ikoc/EkoPedal/images/onOffSwitch.jpeg

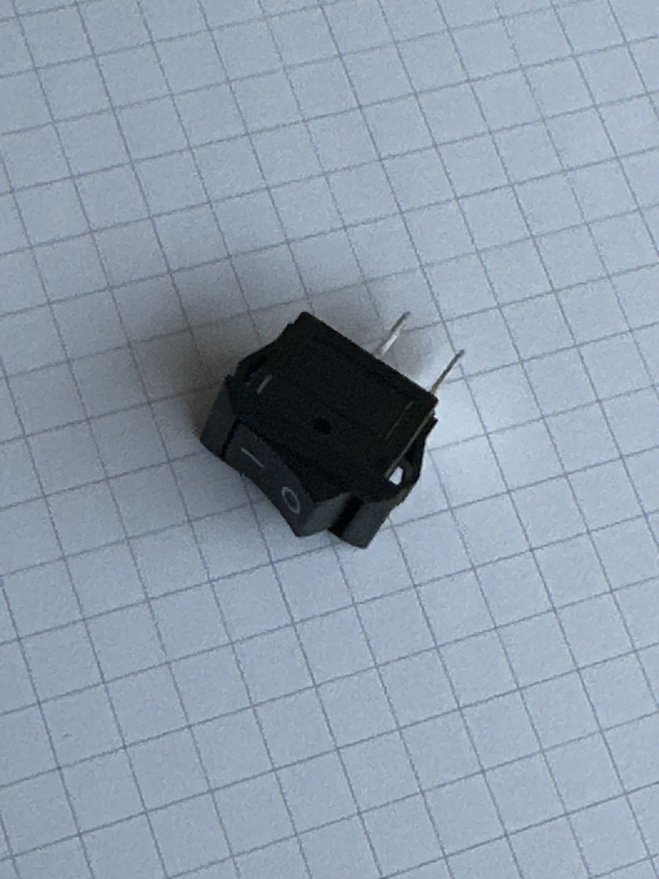
images/onOffSwitch.jpeg
