ikoc/EkoPedal/images/buttonImg.jpeg

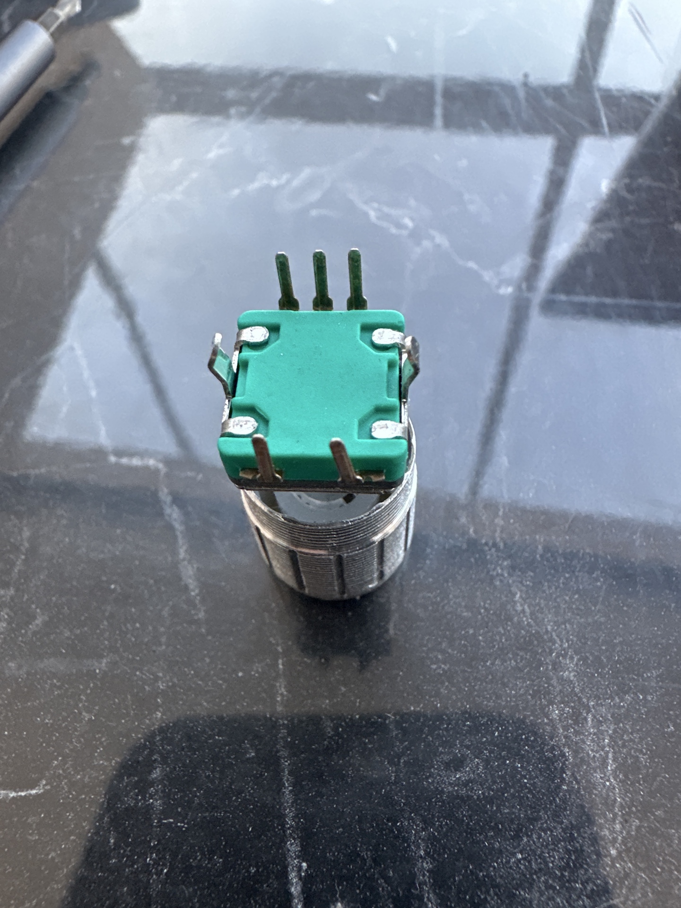
images/buttonImg.jpeg
