ikoc/EkoPedal/profiles/README.md

# Profiles

Aşama 2'de JSON makro profilleri burada tutulacak.
