ikoc/EkoPedal/cad/cikti/B_arka.png

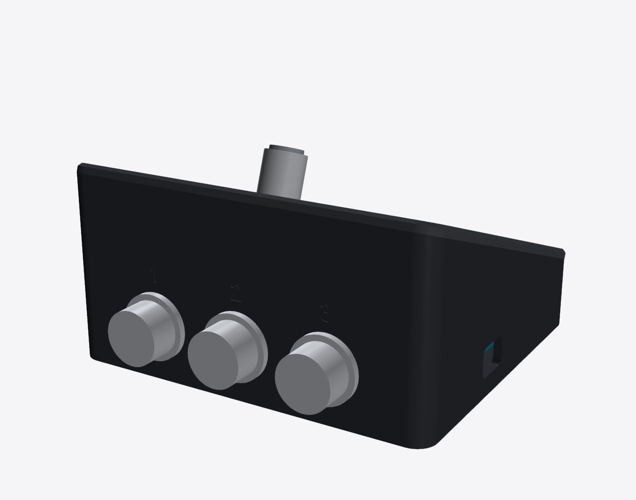
cad/cikti/B_arka.png
