ikoc/EkoPedal/cad/cikti/B_enkoder_tutucu.png

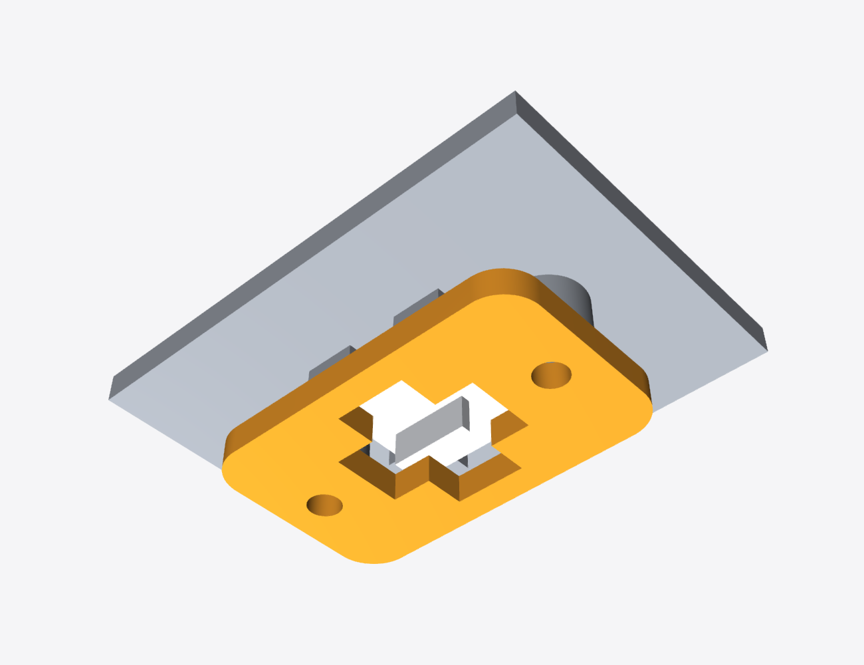
cad/cikti/B_enkoder_tutucu.png
