ikoc/EkoPedal/cad/cikti/B_on.png

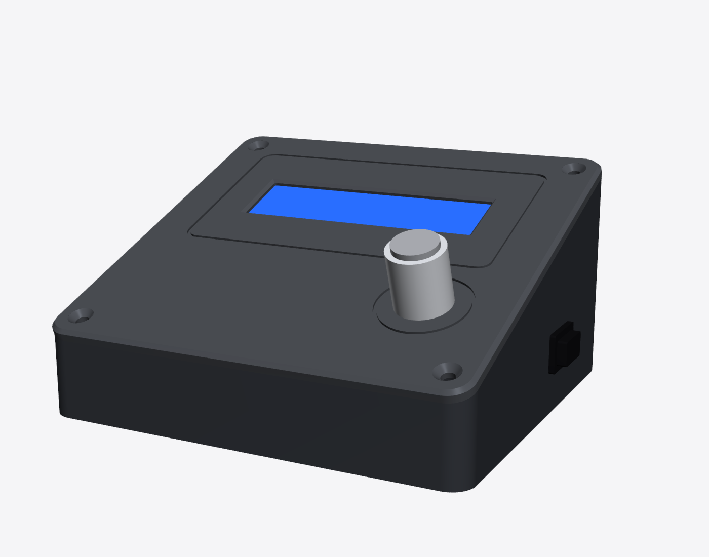
cad/cikti/B_on.png
