ikoc/EkoPedal/cad/cikti/B_panel_alt.png

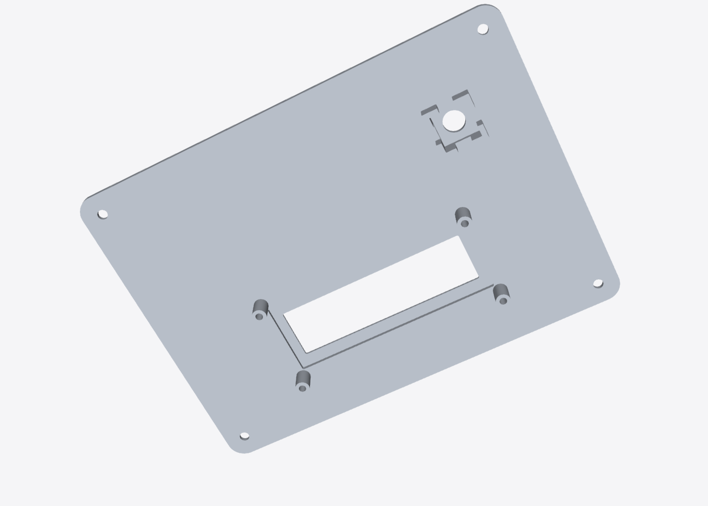
cad/cikti/B_panel_alt.png
