ikoc/EkoPedal/images/Image.jpeg

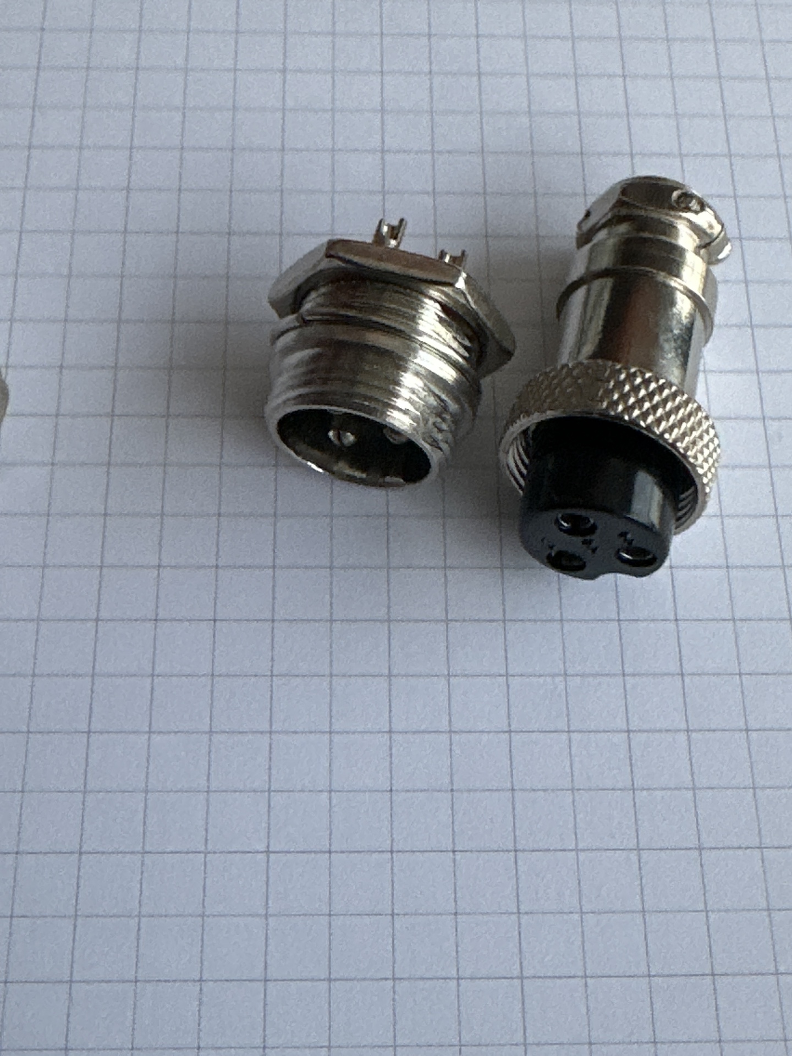
images/Image.jpeg
