ikoc/EkoPedal/images/referansImg.webp

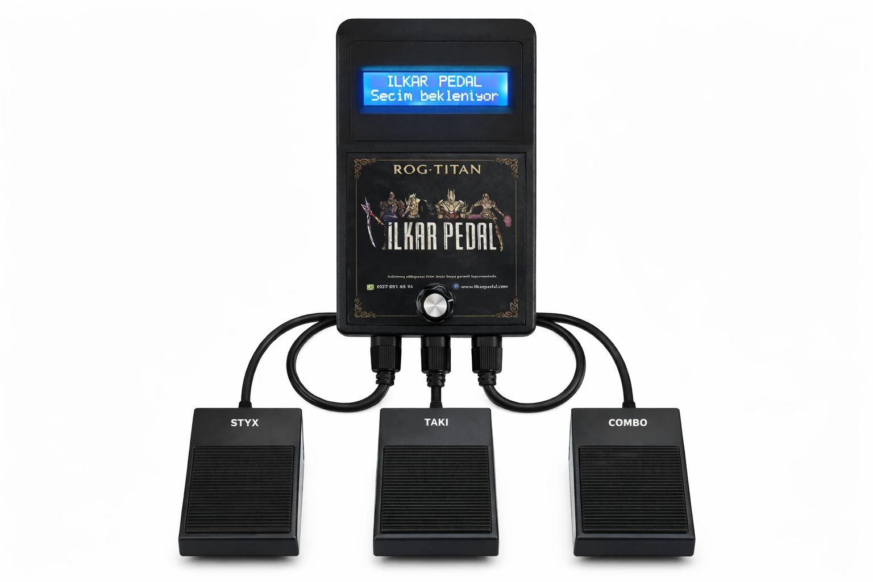
images/referansImg.webp
