ikoc/EkoPedal/cad/baski/B_kama/B_govde.stl

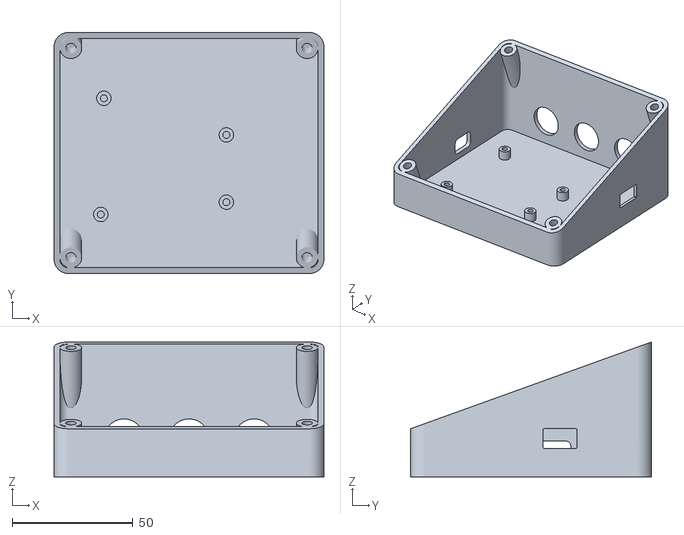
[picture p10: CAD file, 2026-10-25]
cad/baski/B_kama/B_govde.stl
112.0 x 100.0 x 56.0
