ikoc/EkoPedal/cad/baski/B_kama/B_test_kuponu.stl

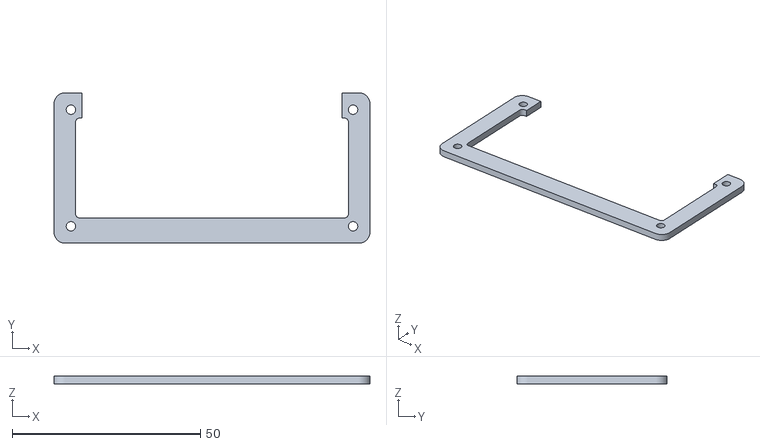
[picture p11: CAD file, 2026-10-25]
cad/baski/B_kama/B_test_kuponu.stl
84.0 x 40.0 x 2.00
