ikoc/EkoPedal/cad/baski/B_kama/B_panel.stl

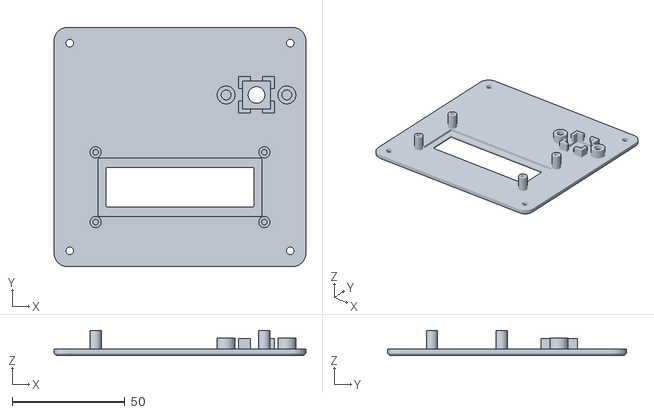
[picture p12: CAD file, 2026-10-25]
cad/baski/B_kama/B_panel.stl
112.0 x 106.3 x 11.2
