ikoc/EkoPedal/cad/baski/B_kama/B_enkoder_tutucu.stl

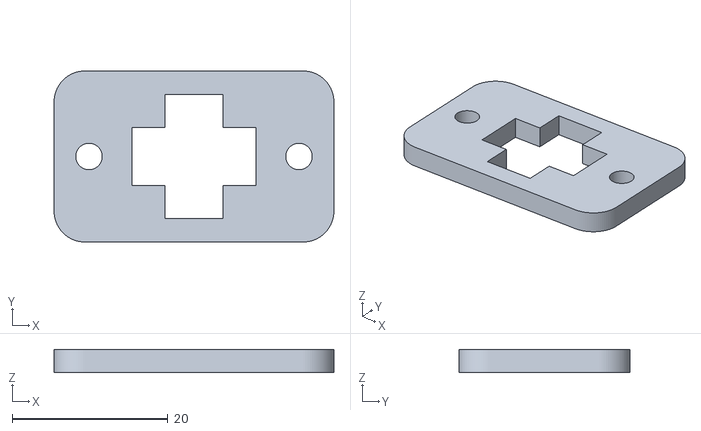
[picture p13: CAD file, 2026-10-24]
cad/baski/B_kama/B_enkoder_tutucu.stl
36.0 x 22.0 x 3.00
