ikoc/EkoPedal/cad/cikti/B_test_kuponu.png

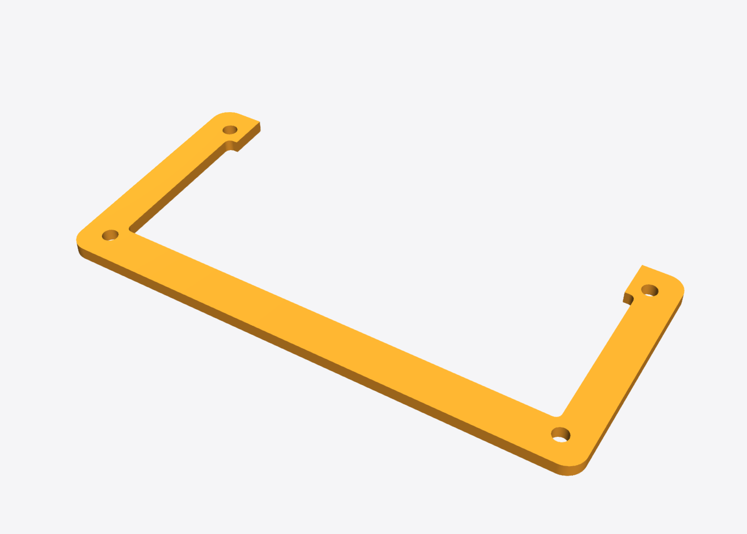
cad/cikti/B_test_kuponu.png
