ikoc/EkoPedal/(commit log)

2026-10-24 Kutu tasarımları (CAD, STL), LCD kodu ve bileşen fotoğrafları eklendi
    - cad/: CadQuery ile 3 kontrol kutusu tasarımı (A Kule, B Kama, C Yatay), Bambu Lab X2D için
    baskı yönünde STL'ler. Seçilen B Kama: 112 x 100 x 59 mm, ölçülmüş bileşenlere göre
    (LCD 74x30 delik, EC11 düz mil + tutucu, mini rocker 13x8, GX16, Leonardo), 6 x M3x4x5 insert (Ø4.4).
    - cad/baski/B_kama/B_test_kuponu.stl: LCD, enkoder+tutucu, insert, anahtar, GX16 geçme testi.
    - cad/cikti/EkoPedal_3B.html: patlatma/kesit/yarı saydam 3B görüntüleyici; renderlar.
    - arduino lcd led/: HW-61 I2C LCD kütüphanesi (LcdEkran), enkoder ve I2C tarayıcı testleri.
    - images/: referans ve bileşen fotoğraflar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
    [A_govde.stl, A_kapak.stl, B_enkoder_tutucu.stl, B_govde.stl, B_panel.stl, B_test_kuponu.stl, B_yazi_inlay.stl, C_egim_ayagi_1.stl]
2026-10-25 B Kama: kupon sonuçları işlendi, A/C ve panel yazısı kaldırıldı
    Test kuponu sonuçları (24-25 Eki):
    - Insert Ø4.4, GX16, enkoder + tutucu: onaylandı.
    - Anahtar deliği 13.2 dar geldi -> 14.0 x 8.3 (onaylandı).
    - LCD vida delikleri 74 x 30 olmadı -> 75 x 31 (onaylandı); kuleler 8.2 mm.
    - Panel altı tutucu insert deliği 5.0 derin (ön yüz kabarmasın), tutucu vidası M3x6.
    Baskı düzeltmesi:
    - Ön yüz tablada basılan panelde 88x48 LCD girintisi tabanı havada kalıyordu
    (kupon 2'de LCD bölümü tablaya tutmadı) -> 0.8 mm ince çerçeve oluğu.
    Temizlik:
    - A (Kule) ve C (Yatay) tasarımları silindi; sadece B Kama kaldı.
    - "eKO PEDAL" yazı oyuğu ve yazı parçası k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
    [A_govde.stl, A_kapak.stl, B_govde.stl, B_panel.stl, B_test_kuponu.stl, B_yazi_inlay.stl, C_egim_ayagi_1.stl, C_egim_ayagi_2.stl]
2026-10-25 Windows geliştirmesi (EkoPedal_Windows_Dev_2026-10-25.zip)
    Windows bilgisayardaki son dosya hali; o taraftaki git geçmişi (63a6d0f, 6548a97 vb.)
    zip'te olmadığı için tek commit olarak alındı.
    - firmware/leonardo_menu: iç içe menü, eKO PEDAL açılışı, encoder D6/D9 + basma D7,
    5 ms HID zamanlaması, ayar sürümü 9.
    - firmware/lcd_i2c_test: bağımsız HW-61 LCD testi.
    - docs/PROJECT_STATE.md: güncel durum, pin haritası, Windows devam adımları.
    - docs/lcd_menu.md, README.md: PROJECT_STATE'e yönlendirme, encoder pinleri.
2026-10-25 Baskıda doğrulanan montaj ölçüleri kaydedildi, Leonardo ayakları M3'e göre
    - cad/README.md: "Doğrulanmış montaj ölçüleri" tablosu (LCD 75x31 / 8.2 kule, EC11 enkoder cebi +
    tutucu, insert Ø4.4, anahtar 14.0x8.3, GX16 Ø16.2, Leonardo delik konumları) – 25 Eki baskısı.
    - Leonardo ayakları: pilot Ø2.6 -> Ø2.9, derinlik 4.4 -> 6.6 mm (M3 kendi dişini açar, LCD ile aynı yöntem).
    - ortak.py: doğrulanmış ölçüler notu ve LEO_* parametreleri.
    [B_govde.stl]
2026-10-25 Doğrulanmış pin haritası, bağlantı test uygulaması, A0 açma/kapama anahtarı
    - docs/PIN_HARITASI.md: tüm Leonardo pinleri, ortak GND hattı (7 uç), EC11 enkoder bacak dizilimi,
    GX16 konnektör düzeni, pedal ve anahtar davranışı, LCD notları. 25 Eki'de tüm parçalar bağlıyken doğrulandı.
    - firmware/baglanti_testi: hiç tuş göndermeyen test; pedallar, anahtar, enkoder ve butonu LCD'de ve seri portta gösterir.
    - firmware/leonardo_menu: A0 yazılımsal açma/kapama anahtarı. Kapalıyken makrolar durur, tuş/fare bırakılır,
    pedal ve menü bir şey göndermez, LCD "eKO PEDAL / KAPALI". Karta yüklenip anahtar test edildi (I = HAZIR).
    - PROJECT_STATE.md, lcd_menu.md,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
