ikoc/EkoPedal/images/lcdImage.JPG

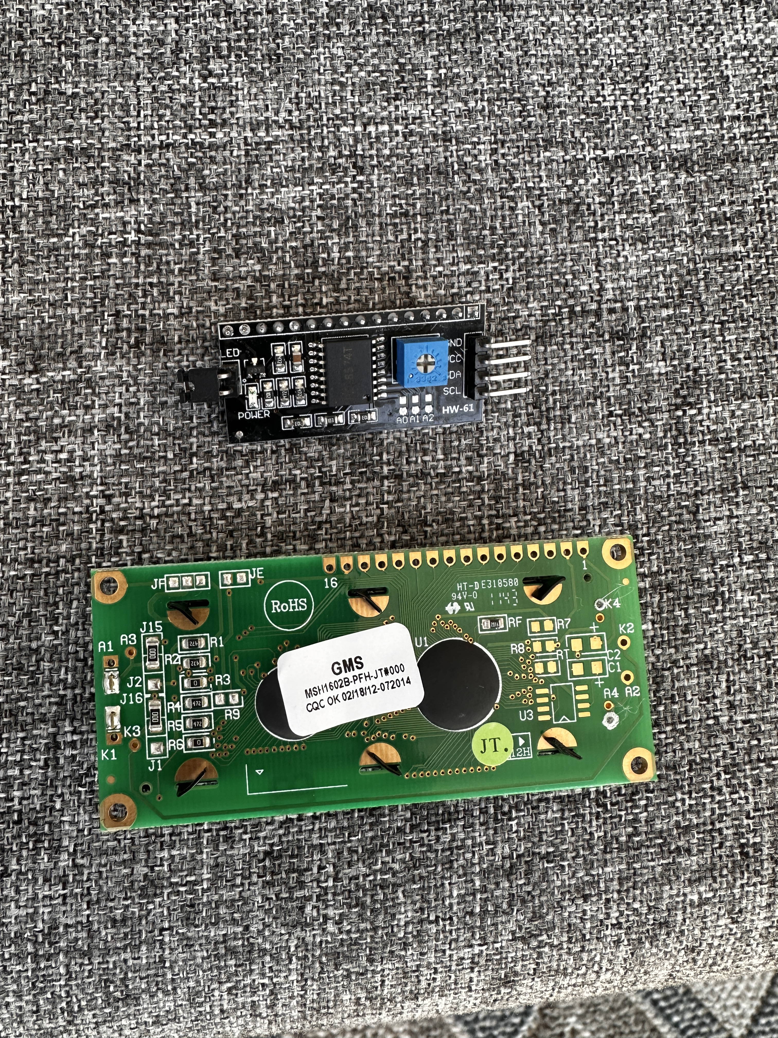
images/lcdImage.JPG
